TVavrinec/SemiSemafor/hw/3D/insert.3mf

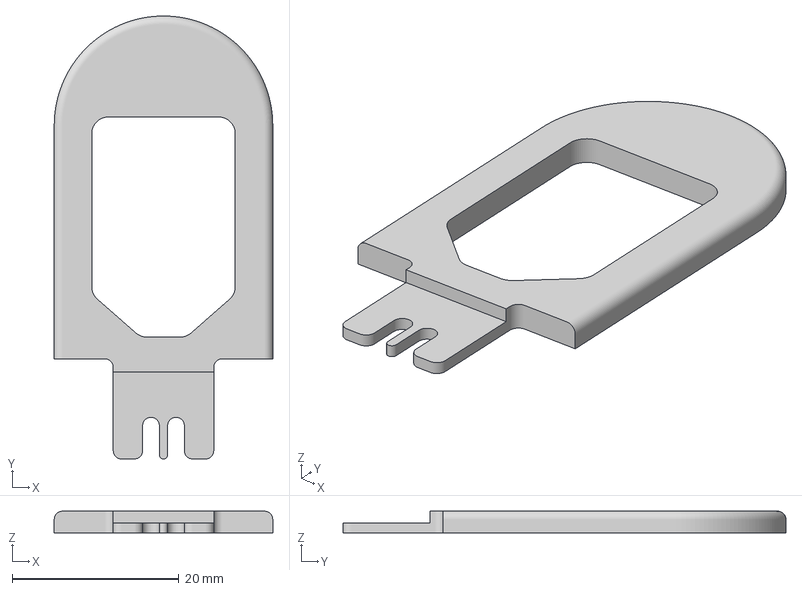
[picture p1: CAD file, 2024-07-02]
hw/3D/insert.3mf
26.2 x 53.1 x 2.60 mm
