TVavrinec/SemiSemafor/hw/3D/drzak.3mf

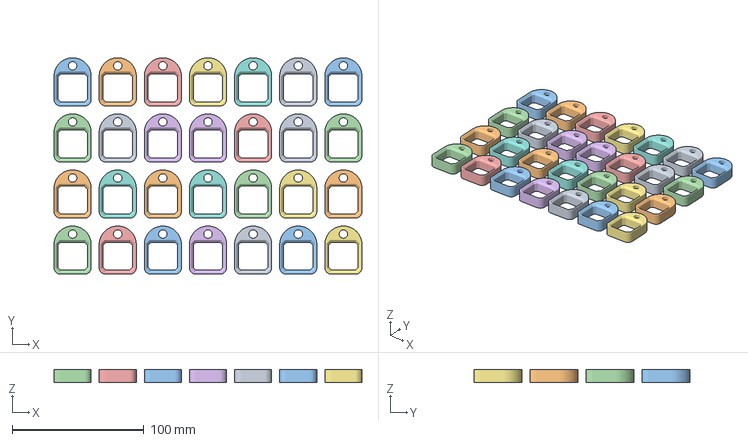
[picture p2: CAD file, 2024-07-02]
hw/3D/drzak.3mf
233.4 x 164.0 x 10.0 mm
