TVavrinec/SemiSemafor/hw/3D/box-monomaterial-ald.3mf

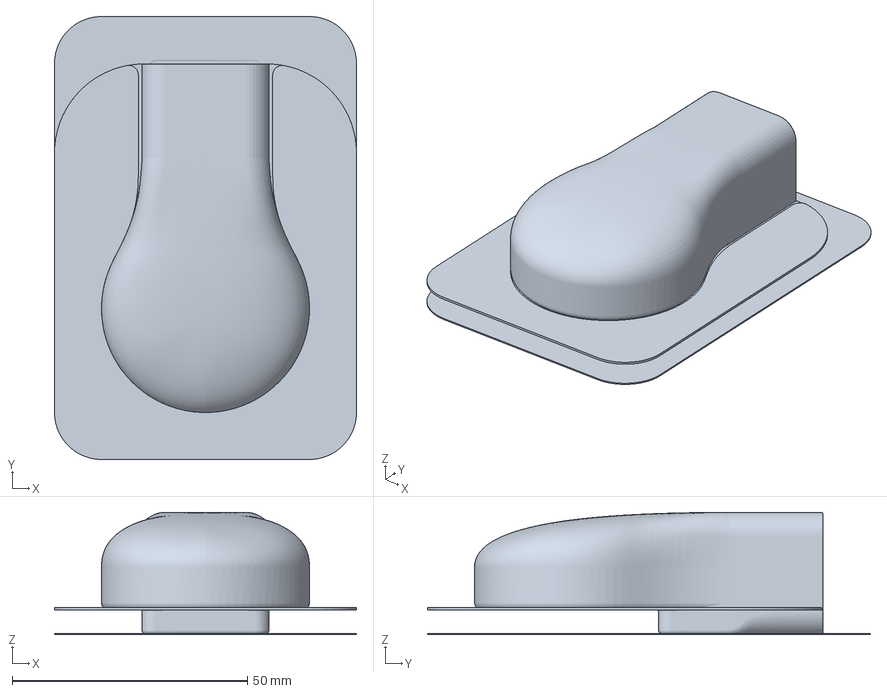
[picture p3: CAD file, 2024-07-02]
hw/3D/box-monomaterial-ald.3mf
64.2 x 94.2 x 26.0 mm
