TVavrinec/SemiSemafor/hw/3D/box-26mm.3mf

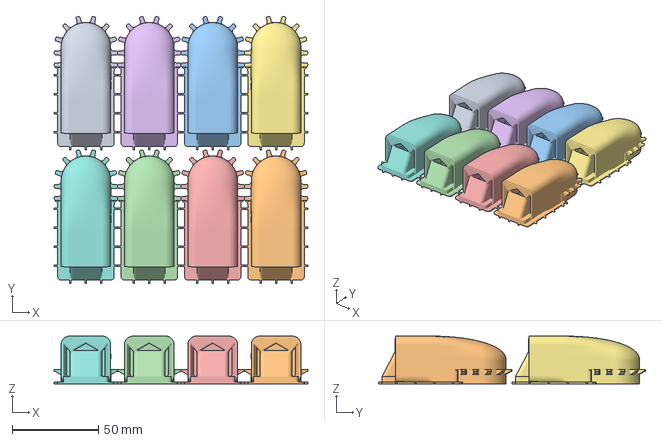
[picture p4: CAD file, 2024-07-02]
hw/3D/box-26mm.3mf
147.2 x 155.0 x 27.8 mm
