TVavrinec/SemiSemafor/hw/3D/Powerbank-holder.3mf

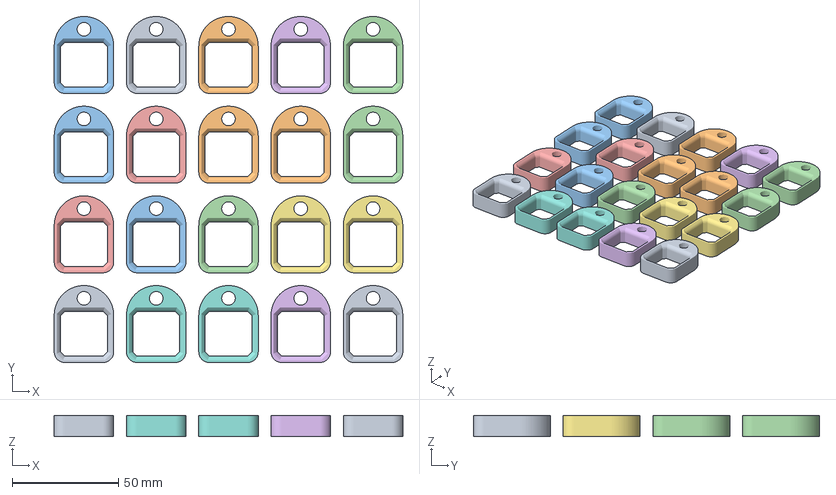
[picture p5: CAD file, 2024-07-01]
hw/3D/Powerbank-holder.3mf
164.0 x 162.8 x 10.0 mm
