TVavrinec/SemiSemafor/hw/SemiSemafor/SemiSemafor.kicad_pcb

## KiCad design hw/SemiSemafor/SemiSemafor.kicad_pcb (2024-05-07)

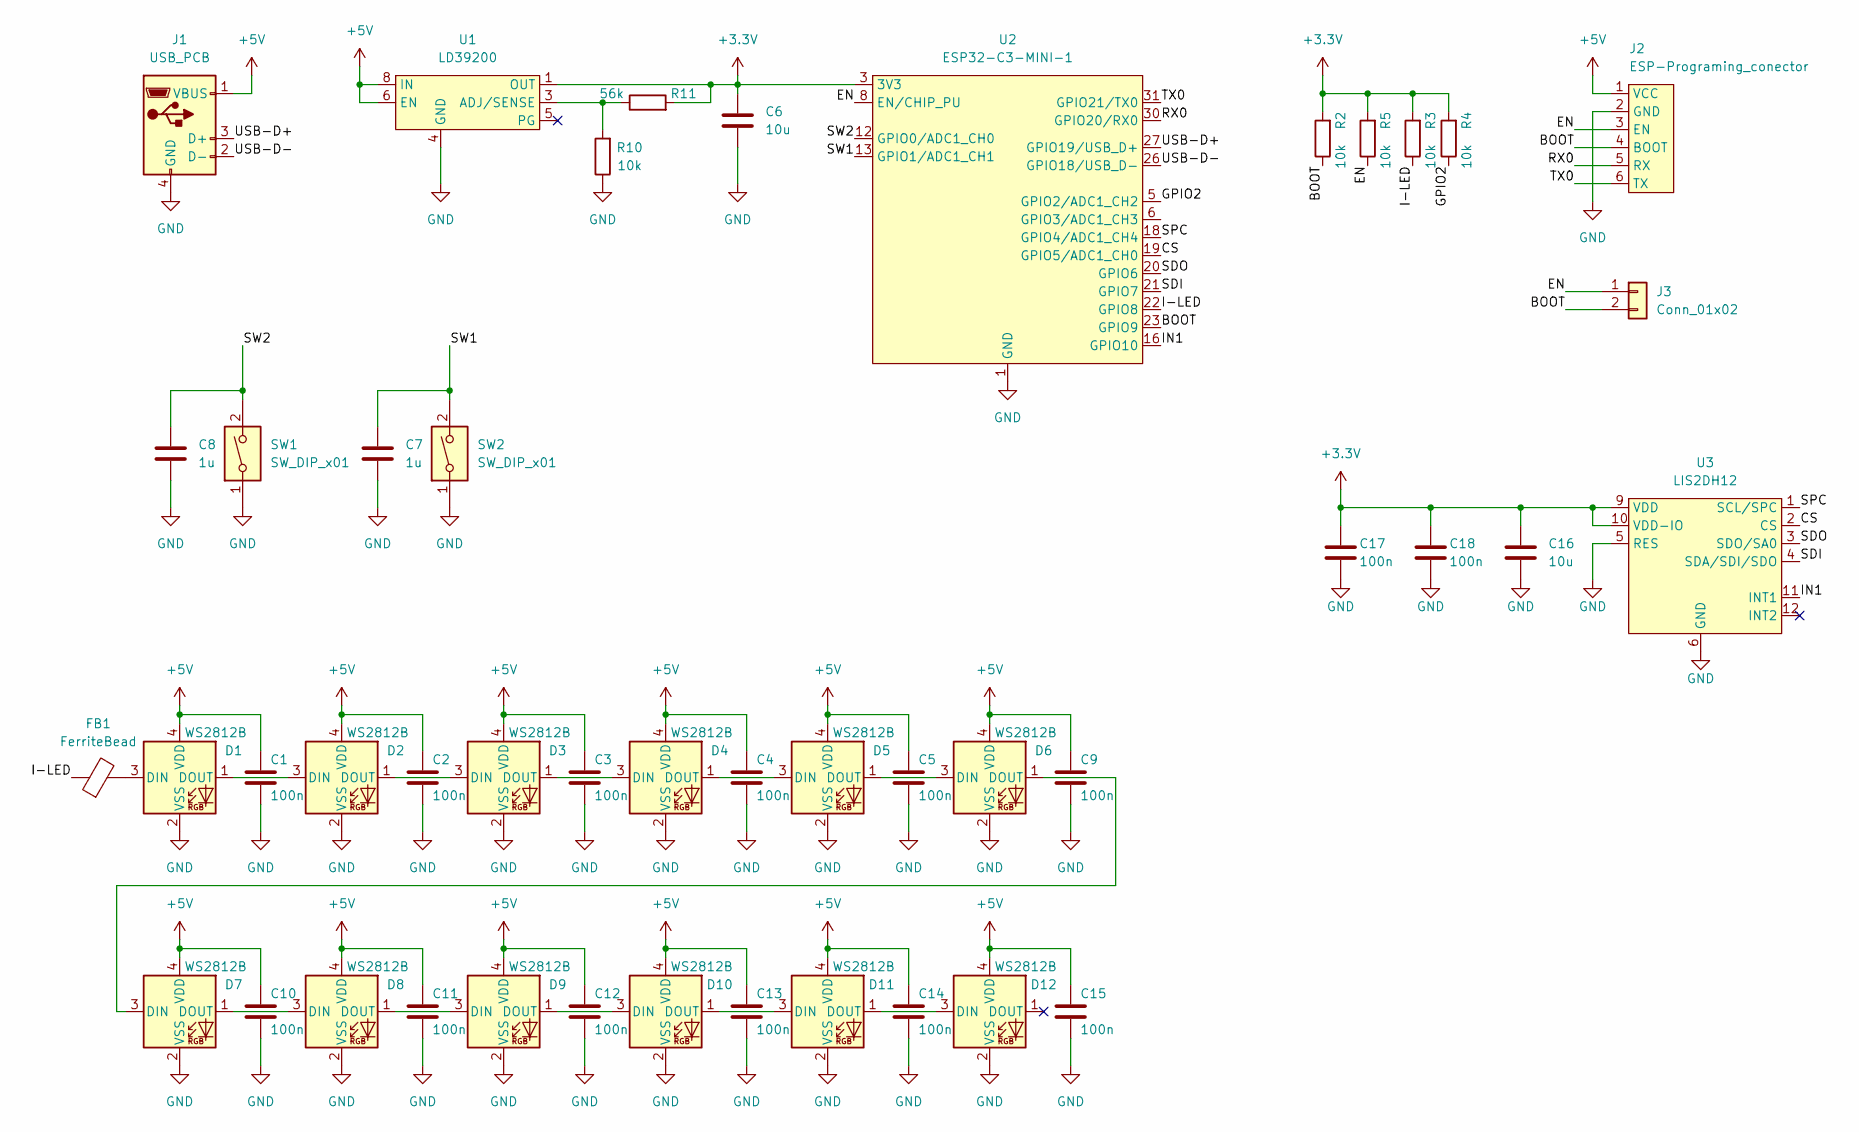
[picture p6: schematic SemiSemafor.kicad_sch]

Parts:
C1, C2, C3, C4, C5, C9, C10, C11, C12, C13, C14, C15: 100n; C_0603_1608Metric; LCSC C14663
C6, C16: 10u; C_0603_1608Metric; LCSC C19702
C7, C8: 1u; C_0402_1005Metric; LCSC C52923
C17, C18: 100n; C_0402_1005Metric; LCSC C1525
D1, D2, D3, D4, D5, D6, D7, D8, D9, D10, D11, D12: WS2812B; LED_WS2812B-2020_PLCC4_2.0x2.0mm; LCSC C965555
FB1: FerriteBead; L_0402_1005Metric; LCSC C275411
J1: USB_PCB; usb-PCB
J2: ESP-Programing_conector
J3: Conn_01x02; ESP-Small-programming connector
R2, R3, R4, R5, R10: 10k; R_0402_1005Metric; LCSC C25744
R11: 56k; R_0402_1005Metric; LCSC C25796
SW1, SW2: SW_DIP_x01; SW_Push_1P1T_NO_Vertical_Wuerth_434133025816; LCSC C127488
U1: LD39200; DFN-8-1EP_4x4mm_P0.8mm_EP2.3x3.24mm; LCSC C880590
U2: ESP32-C3-MINI-1; LCSC C2838502
U3: LIS2DH12; LGA-12_2x2mm_P0.5mm; LCSC C110926

Connections:
+3.3V: C6.1, C16.1, C17.1, C18.1, R2.2, R3.2, R4.2, R5.2, R11.2, U1.1 (OUT), U1.2 (OUT), U2.3 (3V3), U2.7, U3.9 (VDD), U3.10 (VDD-IO)
+5V: C1.1, C2.1, C3.1, C4.1, C5.1, C9.1, C10.1, C11.1, C12.1, C13.1, C14.1, C15.1, D1.4 (VDD), D2.4 (VDD), D3.4 (VDD), D4.4 (VDD), D5.4 (VDD), D6.4 (VDD), D7.4 (VDD), D8.4 (VDD), D9.4 (VDD), D10.4 (VDD), D11.4 (VDD), D12.4 (VDD), J1.1 (VBUS), J2.1 (VCC), U1.6 (EN), U1.7 (IN), U1.8 (IN)
/BOOT: J2.4 (BOOT), J3.2, R2.1, U2.23 (GPIO9)
/CS: U2.19 (GPIO5/ADC1_CH0), U3.2 (CS)
/EN: J2.3 (EN), J3.1, R5.1, U2.8 (EN/CHIP_PU)
/GPIO2: R4.1, U2.5 (GPIO2/ADC1_CH2)
/I-LED: FB1.1, R3.1, U2.22 (GPIO8)
/IN1: U2.16 (GPIO10), U3.11 (INT1)
/RX0: J2.5 (RX), U2.30 (GPIO20/RX0)
/SDI: U2.21 (GPIO7), U3.4 (SDA/SDI/SDO)
/SDO: U2.20 (GPIO6), U3.3 (SDO/SA0)
/SPC: U2.18 (GPIO4/ADC1_CH4), U3.1 (SCL/SPC)
/SW1: C7.1, SW2.2, U2.13 (GPIO1/ADC1_CH1)
/SW2: C8.1, SW1.2, U2.12 (GPIO0/ADC1_CH0)
/TX0: J2.6 (TX), U2.31 (GPIO21/TX0)
/USB-D+: J1.3 (D+), U2.27 (GPIO19/USB_D+)
/USB-D-: J1.2 (D-), U2.26 (GPIO18/USB_D-)
GND: C1.2, C2.2, C3.2, C4.2, C5.2, C6.2, C7.2, C8.2, C9.2, C10.2, C11.2, C12.2, C13.2, C14.2, C15.2, C16.2, C17.2, C18.2, D1.2 (VSS), D2.2 (VSS), D3.2 (VSS), D4.2 (VSS), D5.2 (VSS), D6.2 (VSS), D7.2 (VSS), D8.2 (VSS), D9.2 (VSS), D10.2 (VSS), D11.2 (VSS), D12.2 (VSS), J1.4 (GND), J2.2 (GND), R10.1, SW1.1, SW2.1, U1.4 (GND), U1.9 (GND), U2.1 (GND), U2.2 (GND), U2.11 (GND), U2.14 (GND), U2.36 (GND), U2.37 (GND), U2.38 (GND), U2.39 (GND), U2.40 (GND), U2.41 (GND), U2.42 (GND), U2.43 (GND), U2.44 (GND), U2.45 (GND), U2.46 (GND), U2.47 (GND), U2.48 (GND), U2.49 (GND), U2.50 (GND), U2.51 (GND), U2.52 (GND), U2.53 (GND), U3.5 (RES), U3.6 (GND), U3.7 (GND), U3.8 (GND)
unnamed: D1.3 (DIN), FB1.2
unnamed: D1.1 (DOUT), D2.3 (DIN)
unnamed: D2.1 (DOUT), D3.3 (DIN)
unnamed: D3.1 (DOUT), D4.3 (DIN)
unnamed: D4.1 (DOUT), D5.3 (DIN)
unnamed: D5.1 (DOUT), D6.3 (DIN)
unnamed: D6.1 (DOUT), D7.3 (DIN)
unnamed: D7.1 (DOUT), D8.3 (DIN)
unnamed: D8.1 (DOUT), D9.3 (DIN)
unnamed: D9.1 (DOUT), D10.3 (DIN)
unnamed: D10.1 (DOUT), D11.3 (DIN)
unnamed: D11.1 (DOUT), D12.3 (DIN)
unnamed: R10.2, R11.1, U1.3 (ADJ/SENSE)

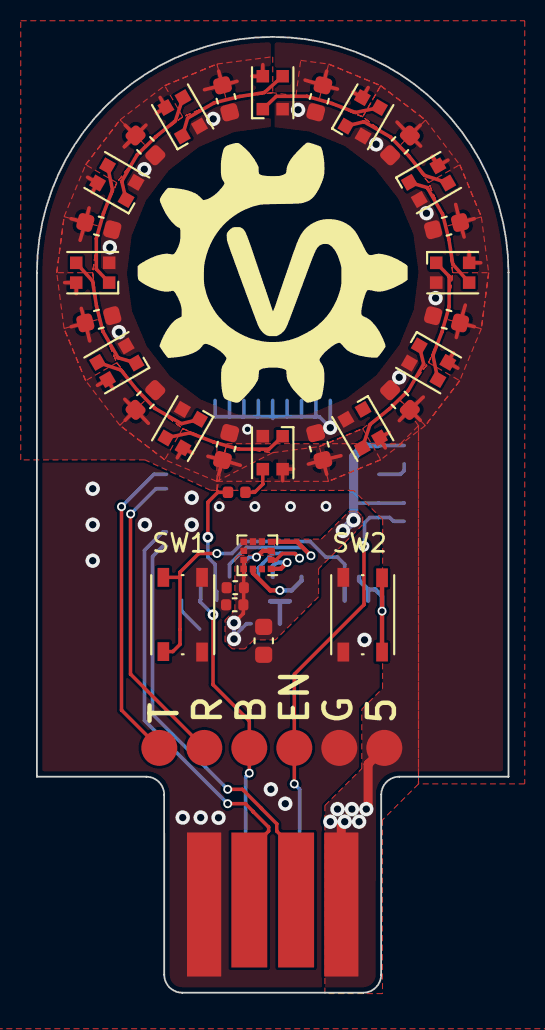
[picture p7: board SemiSemafor.kicad_pcb from above]

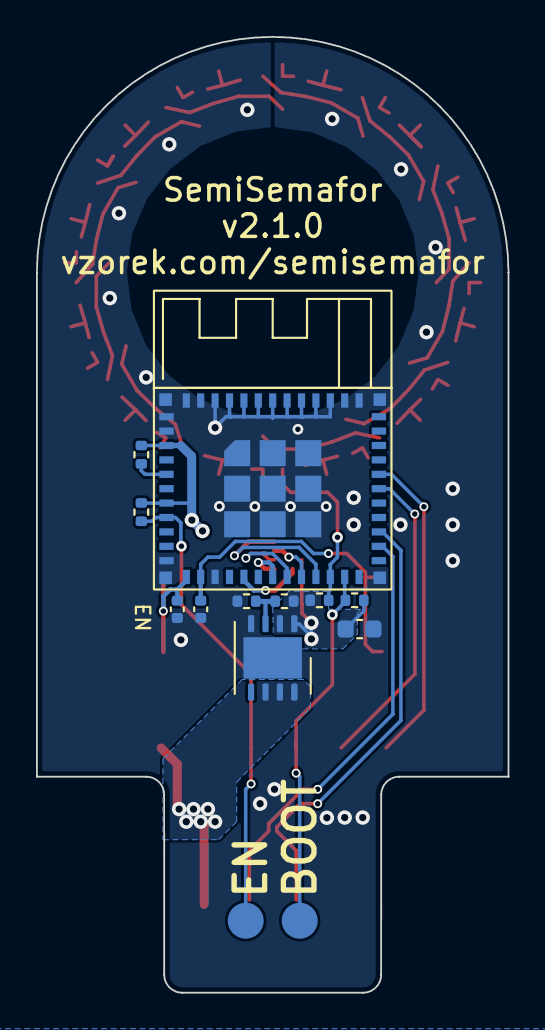
[picture p8: board SemiSemafor.kicad_pcb from below]

Board: 2 copper layers, 26.2 x 53.1 mm, 45 parts (12 on the bottom side), 31 nets.
