TVavrinec/SemiSemafor/(commit log)

2023-04-06 Change button connection
    [SemiSemafor.kicad_pcb, SemiSemafor.kicad_sch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]
2023-06-12 fix LDO
    [SemiSemafor.kicad_pcb, SemiSemafor.kicad_sch]
2023-08-03 Fix LDO, add button and programming connector
    [SemiSemafor.kicad_sch]
2023-08-06 Polygon and rout tracks correction
    [SemiSemafor.kicad_pcb, SemiSemafor.kicad_sch]
2024-02-15 12 LED
    [SemiSemafor.kicad_sch]
2024-02-15 V2.0 (Circuit)
    [SemiSemafor.kicad_pcb, SemiSemafor.kicad_sch]
2024-02-18 Small ring
    [SemiSemafor.kicad_pcb, SemiSemafor.kicad_sch]
2024-02-18 Copper around the hole
    [SemiSemafor.kicad_pcb]
2024-02-18 Ring 26mm
    [SemiSemafor.kicad_pcb, SemiSemafor.kicad_sch]
2024-04-21 Add IMU and move LED ring higher
    [SemiSemafor.kicad_pcb, SemiSemafor.kicad_sch]
2024-04-26 PCB extension
    [SemiSemafor.kicad_pcb]
2024-04-28 Update led count to Semafor
2024-04-28 feat: test imu on semafor
2024-05-06 Simplified polygons
    [SemiSemafor.kicad_pcb]
2024-05-07 Change package of FB1
    [SemiSemafor.kicad_pcb, SemiSemafor.kicad_sch]
2024-06-06 Add print data
2024-06-07 Powerbank holder
    [Powerbank-holder.3mf]
2024-06-13 Betr print senings and insert
    [insert.3mf]
2024-07-02 3D models
    [box-26mm.3mf, box-monomaterial-ald.3mf, drzak.3mf]
2024-07-02 3D model of insert
    [insert.3mf]
